akmorrison/long_count/schematics/long_count.kicad_pcb

## KiCad design schematics/long_count.kicad_pcb (2018-03-05)

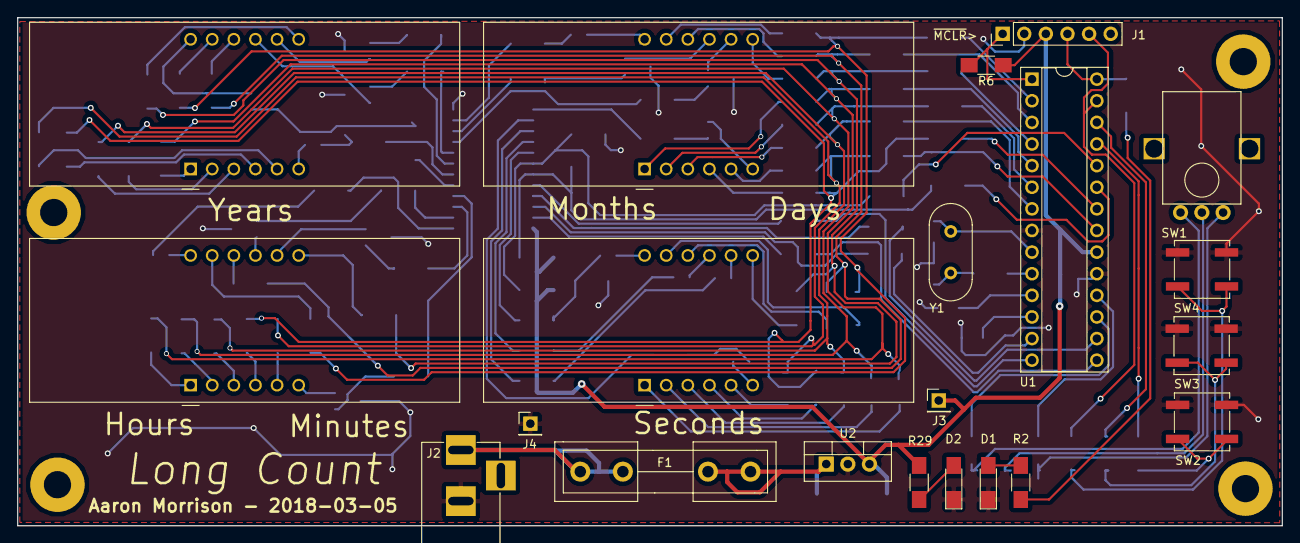
[picture p1: board long_count.kicad_pcb from above]

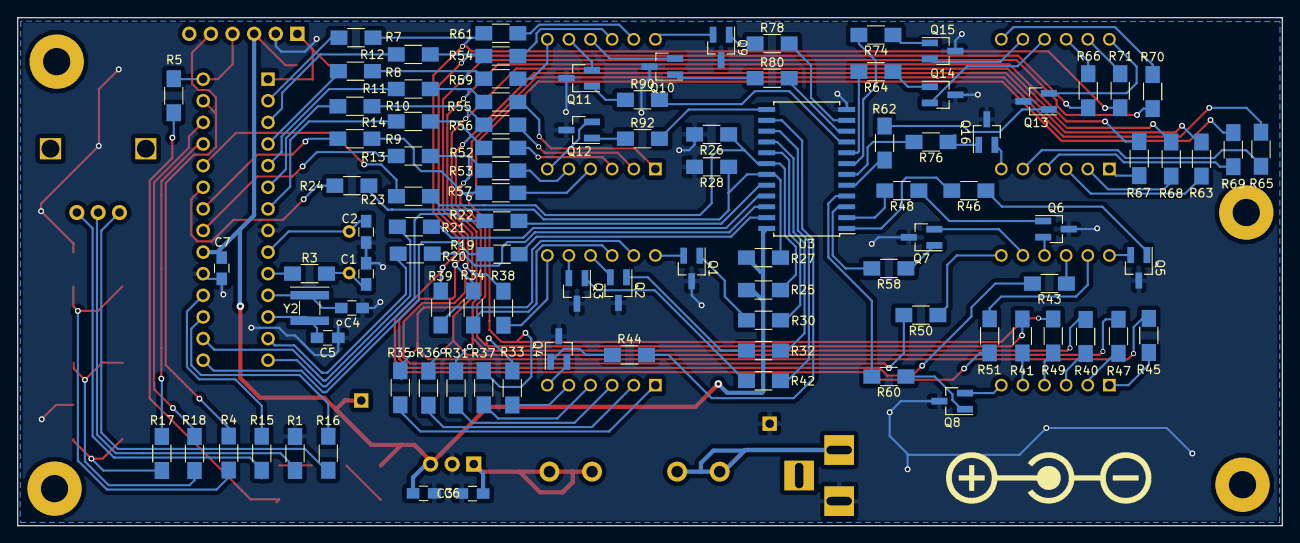
[picture p2: board long_count.kicad_pcb from below]

Board: 2 copper layers, 148.6 x 59.7 mm, 120 parts (99 on the bottom side), 133 nets.

Parts:
AFF1, AFF2, AFF3, AFF4: CC56-12; CA56-12SYKWA
C1, C2, C3, C4, C5, C6, C7: C; C_0805_HandSoldering
D1: STAT; LED_1206_HandSoldering
D2: PWR; LED_1206_HandSoldering
F1: Fuse; Fuseholder5x20_horiz_open_inline_Type-I
J1: PICKIT connector; Pin_Header_Straight_1x06_Pitch2.54mm
J2: BARREL_JACK
J3: VDD; Pin_Header_Straight_1x01_Pitch2.54mm
J4: VSS; Pin_Header_Straight_1x01_Pitch2.54mm
Q1, Q2, Q3, Q4, Q5, Q6, Q7, Q8, Q9, Q10, Q11, Q12, Q13, Q14, Q15, Q16: Q_PNP_BEC; SOT-23_Handsoldering
R1, R4, R5, R7, R8, R9, R10, R11, R12, R13, R14, R15, R16, R17, R18, R19, R20, R21, R22, R23, R24: 0; R_1206_HandSoldering
R2, R29, R31, R33, R34, R35, R36, R37, R38, R39, R40, R41, R43, R45, R47, R49, R50, R51, R52, R53, R54, R55, R56, R57, R59, R61, R63, R65, R66, R67, R68, R69, R70, R71: 330; R_1206_HandSoldering
R3: R; R_1206_HandSoldering
R6, R25, R26, R27, R28: 10k; R_1206_HandSoldering
R30, R32, R42, R44, R46, R48, R58, R60, R62, R64, R74, R76, R78, R80, R90, R92: 1K; R_1206_HandSoldering
SW1: Rotary_Encoder; rotary_encoder
SW2, SW3, SW4: SW_Push; SW_SPST_B3SL-1002P
U1: PIC18F27K40; DIP-28_W7.62mm_Socket
U2: LM7805CT; TO-220-3_Vertical
U3: CD74HC154M96; SOIC-24W_7.5x15.4mm_Pitch1.27mm
Y1: 12MHz; Crystal_HC49-4H_Vertical
Y2: 32.768KHz; Resonator_SMD_muRata_CDSCB-2pin_4.5x2.0mm_HandSoldering

Connections:
+5V: C6.2, C7.2, J1.3, J3.1, R6.1, R25.1, R27.1, R29.2, U1.20, U2.3, U3.24
/SevSeg2/DIG_1: R62.2, U3.5
/SevSeg2/DIG_2: R64.2, U3.8
/SevSeg2/DIG_3: R74.2, U3.7
/SevSeg2/DIG_4: R76.2, U3.6
/SevSeg3/DIG_1: R78.2, U3.11
/SevSeg3/DIG_2: R80.2, U3.10
/SevSeg3/DIG_3: R90.2, U3.9
/SevSeg3/DIG_4: R92.2, U3.13
/SevSeg4/DIG_1: R30.2, U3.17
/SevSeg4/DIG_2: R32.2, U3.16
/SevSeg4/DIG_3: R42.2, U3.15
/SevSeg4/DIG_4: R44.2, U3.14
/SevSeg/DIG_1: R46.2, U3.1
/SevSeg/DIG_2: R48.2, U3.2
/SevSeg/DIG_3: R58.2, U3.3
/SevSeg/DIG_4: R60.2, U3.4
GND: C1.2, C2.2, C3.1, C4.1, C5.1, C6.1, C7.1, D1.1, D2.1, J1.2, J2.2, J4.1, Q1.3, Q2.3, Q3.3, Q4.3, Q5.3, Q6.3, Q7.3, Q8.3, Q9.3, Q10.3, Q11.3, Q12.3, Q13.3, Q14.3, Q15.3, Q16.3, R1.1, R26.2, R28.2, SW2.1, SW3.1, SW4.1, U1.8, U1.19, U2.2, U3.12
ICSPCLK: J1.5, R4.1, U1.27
ICSPDAT: J1.4, R5.1, U1.28
unnamed: AFF1.1, R35.1
unnamed: AFF1.2, R36.1
unnamed: AFF1.3, R31.1
unnamed: AFF1.4, R37.1
unnamed: AFF1.5, R33.1
unnamed: AFF1.6, Q4.2
unnamed: AFF1.7, R38.1
unnamed: AFF1.8, Q3.2
unnamed: AFF1.9, Q2.2
unnamed: AFF1.10, R34.1
unnamed: AFF1.11, R39.1
unnamed: AFF1.12, Q1.2
unnamed: AFF2.1, R45.1
unnamed: AFF2.2, R47.1
unnamed: AFF2.3, R40.1
unnamed: AFF2.4, R49.1
unnamed: AFF2.5, R41.1
unnamed: AFF2.6, Q8.2
unnamed: AFF2.7, R50.1
unnamed: AFF2.8, Q7.2
unnamed: AFF2.9, Q6.2
unnamed: AFF2.10, R43.1
unnamed: AFF2.11, R51.1
unnamed: AFF2.12, Q5.2
unnamed: AFF3.1, R67.1
unnamed: AFF3.2, R68.1
unnamed: AFF3.3, R63.1
unnamed: AFF3.4, R69.1
unnamed: AFF3.5, R65.1
unnamed: AFF3.6, Q16.2
unnamed: AFF3.7, R70.1
unnamed: AFF3.8, Q15.2
unnamed: AFF3.9, Q14.2
unnamed: AFF3.10, R66.1
unnamed: AFF3.11, R71.1
unnamed: AFF3.12, Q13.2
unnamed: AFF4.1, R55.1
unnamed: AFF4.2, R56.1
unnamed: AFF4.3, R52.1
unnamed: AFF4.4, R57.1
unnamed: AFF4.5, R53.1
unnamed: AFF4.6, Q12.2
unnamed: AFF4.7, R59.1
unnamed: AFF4.8, Q11.2
unnamed: AFF4.9, Q10.2
unnamed: AFF4.10, R54.1
unnamed: AFF4.11, R61.1
unnamed: AFF4.12, Q9.2
unnamed: C1.1, R3.2, Y1.1
unnamed: C2.1, U1.9, Y1.2
unnamed: C3.2, F1.1, U2.1
unnamed: C4.2, U1.11, Y2.1
unnamed: C5.2, U1.12, Y2.2
unnamed: D1.2, R2.2
unnamed: D2.2, R29.1
unnamed: F1.2, J2.1
unnamed: Q1.1, R30.1
unnamed: Q2.1, R32.1
unnamed: Q3.1, R42.1
unnamed: Q4.1, R44.1
unnamed: Q5.1, R46.1
unnamed: Q6.1, R48.1
unnamed: Q7.1, R58.1
unnamed: Q8.1, R60.1
unnamed: Q9.1, R78.1
unnamed: Q10.1, R80.1
unnamed: Q11.1, R90.1
unnamed: Q12.1, R92.1
unnamed: Q13.1, R62.1
unnamed: Q14.1, R64.1
unnamed: Q15.1, R74.1
unnamed: Q16.1, R76.1
unnamed: R1.2, SW1.2
unnamed: R2.1, R5.2
unnamed: R3.1, U1.10
unnamed: R4.2, SW4.2
unnamed: R7.1, U1.2
unnamed: R8.1, U1.4
unnamed: R9.1, U1.22
unnamed: R10.1, U1.6
unnamed: R11.1, U1.5
unnamed: R12.1, U1.3
unnamed: R13.1, U1.21
unnamed: R14.1, U1.7
unnamed: R15.1, U1.18
unnamed: R15.2, SW1.3
unnamed: R16.1, U1.17
unnamed: R16.2, SW1.1
unnamed: R17.1, U1.25
unnamed: R17.2, SW2.2
unnamed: R18.1, U1.26
unnamed: R18.2, SW3.2
unnamed: R19.1, U3.23
unnamed: R19.2, U1.15
unnamed: R20.1, U3.22
unnamed: R20.2, U1.13
unnamed: R21.1, U3.21
unnamed: R21.2, U1.16
unnamed: R22.1, U3.20
unnamed: R22.2, U1.14
unnamed: R23.1, R25.2, R26.1, U3.18
unnamed: R23.2, U1.24
unnamed: R24.1, R27.2, R28.1, U3.19
unnamed: R24.2, U1.23
SEG_A: R7.2, R39.2, R51.2, R61.2, R71.2
SEG_B: R8.2, R38.2, R50.2, R59.2, R70.2
SEG_C: R9.2, R37.2, R49.2, R57.2, R69.2
SEG_D: R10.2, R36.2, R47.2, R56.2, R68.2
SEG_DP: R14.2, R31.2, R40.2, R52.2, R63.2
SEG_E: R11.2, R35.2, R45.2, R55.2, R67.2
SEG_F: R12.2, R34.2, R43.2, R54.2, R66.2
SEG_G: R13.2, R33.2, R41.2, R53.2, R65.2
~MCLR: J1.1, R6.2, U1.1
