akmorrison/long_count/firmware/main.c

/*
 * File:   main.c
 * Author: aaronmorrison
 *
 * Created on March 16, 2018, 5:22 PM
 */
#define _XTAL_FREQ 64000000
#include <stdio.h>
#include <stdlib.h>
#include "sevenseg.h"
#include "configuration.h"
#include "date_and_time.h"
#include "editing_fsm.h"
#include "buttons.h"

/*
 *
 */
volatile int outputs[16] = {
0,0,0,0,
0,0,0,0,
0,0,0,0,
0,0,0,0 };

static enum {
    COUNTUP,
    COUNTDOWN,
    FROZEN,
    EDITING
} fsm_state;

int main(int argc, char** argv) {
    sevseg_init();

    //configure pins 7&6 on port c as inputs with pullup
    //we do this for the rotary encoder
    TRISCbits.TRISC6 = 1;
    TRISCbits.TRISC7 = 1;
    ANSELC = 0b00111111;
    WPUC =   0b11000000;
    IOCCN =  0b11000000;
    IOCCP =  0b11000000;

    //configure pins 6,5,&4 on port C as inputs with pullup
    //these are the buttons, from top to bottom
    TRISB |= 0b01110000;
    ANSELB = 0b10001111;
    WPUB   = 0b01110000;
    IOCBN  = 0b01110000;

    //why do I need to set this here? No idea man
    fsm_state = EDITING;

    //allow timer and IOC interrupts
    PIE0 = 0b00110000;

    INTCON= 0b11000000;

    //enable timer 0
    T0CON0 = 0b10010000;
    //timer 0 read from LFINTOSC
    T0CON1 = 0b10000000;

    while(1){
        PORTB |= 0x80;

        sevseg_put_number(0,0,outputs[ 0]);
        sevseg_put_number(1,0,outputs[ 1]);
        sevseg_put_number(2,0,outputs[ 2]);
        sevseg_put_number(3,0,outputs[ 3]);
        sevseg_put_number(0,1,outputs[ 4]);
        sevseg_put_number(1,1,outputs[ 5]);
        sevseg_put_number(2,1,outputs[ 6]);
        sevseg_put_number(3,1,outputs[ 7]);
        sevseg_put_number(0,2,outputs[ 8]);
        sevseg_put_number(1,2,outputs[ 9]);
        sevseg_put_number(2,2,outputs[10]);
        sevseg_put_number(3,2,outputs[11]);
        sevseg_put_number(0,3,outputs[12]);
        sevseg_put_number(1,3,outputs[13]);
        sevseg_put_number(2,3,outputs[14]);
        sevseg_put_number(3,3,outputs[15]);
    }
    return (EXIT_SUCCESS);
}

void interrupt isr (void)
{
    //interrupt was generated by timer 0 module
    if(TMR0IF){
        TMR0IF = 0;
        TMR0H = 0xFE;
        TMR0L = 0xC9;
        if(fsm_state == COUNTDOWN) {
            decrement_and_rollover(outputs, 0);
        }
        else if(fsm_state == COUNTUP) {
            increment_and_rollover(outputs, 0);
        }
        else if(fsm_state == EDITING) {
            edit_state_during(outputs);
        }
    }
    else if(IOCIF){
        //check what pin it was
        if(IOCCF7) {
            //interrupt came from B channel of rotary encoder
            IOCCF7 = 0;
            if(fsm_state == EDITING)
                handle_change_rot_b(outputs);
        } else if(IOCCF6) {
            //interrupt came from A channel of rotary encoder
            IOCCF6 = 0;
            if(fsm_state == EDITING)
                handle_change_rot_a(outputs);
        } else if(IOCBF6) {
            IOCBF6 = 0;
            //top button
            if(fsm_state == EDITING)
                edit_state_right_button_cb(outputs);
        } else if(IOCBF5) {
            IOCBF5 = 0;
            //middle button
            if(fsm_state == EDITING) {
                edit_state_leave(outputs);
                fsm_state = COUNTDOWN;
            } else {
                edit_state_enter(outputs);
                fsm_state = EDITING;
            }
        } else if(IOCBF4) {
            IOCBF4 = 0;
            //bottom button
            if(fsm_state == EDITING)
                edit_state_left_button_cb(outputs);
        }
        IOCIF = 0;
    }
    //we don't know what caused interrupt, so block
    else{
        while(1) {}
    }
}
