akmorrison/long_count/(commit log)

2018-03-05 Clean up schematic
    More readable, some notes on components and decisions, and a proper
    linear regulator. 7805 4lyfe.
    [SevSeg.sch, long_count.sch]
2018-03-05 Add mounting holes
    [long_count.kicad_pcb]
2018-03-05 Add silkscreen, move top left mounting hole so it's uncovered
    [long_count.kicad_pcb]
2018-03-05 Change socket hole diameter to 1mm, instead of 0.8mm
    [long_count.kicad_pcb]
2018-03-05 remove tracks through pads
    [long_count.kicad_pcb]
2018-03-05 Generate gerbers
    [long_count-B.Cu.gbr, long_count-B.Mask.gbr, long_count-B.SilkS.gbr, long_count-Edge.Cuts.gbr, long_count-F.Cu.gbr, long_count-F.Mask.gbr, long_count-F.SilkS.gbr, long_count.drl]
2018-03-05 Add test points for VDD and VSS
    Also add center positive polarity symbol for DC input
    [long_count-B.Cu.gbr, long_count-B.Mask.gbr, long_count-B.SilkS.gbr, long_count-Edge.Cuts.gbr, long_count-F.Cu.gbr, long_count-F.Mask.gbr, long_count-F.SilkS.gbr, long_count.drl]
2018-03-05 Rename gerber files to a more standard naming convention
    Add DS_Store to gitignore because macs are weird
    [long_count.GBL, long_count.GBO, long_count.GBS, long_count.GKO, long_count.GTL, long_count.GTO, long_count.GTS]
2018-03-09 Create a bom
2018-03-16 Add PIC datasheet link to bom
2018-06-30 Add seven segment display driver code
2018-06-30 Add configuration bits so it runs
    [configuration.h]
2018-07-02 Get rotary encoder working
    It counts up and down when you rotate it
2018-07-02 Add a basic editing mode
    A number blinks. rotary encoder increases or decreases that number.
    Buttons let you move the blinking number back and forth.
